Siva130603/Bluetooth-Based-Secure-Locker-with-Access-Logging/IMG-20260924-WA0004.jpg

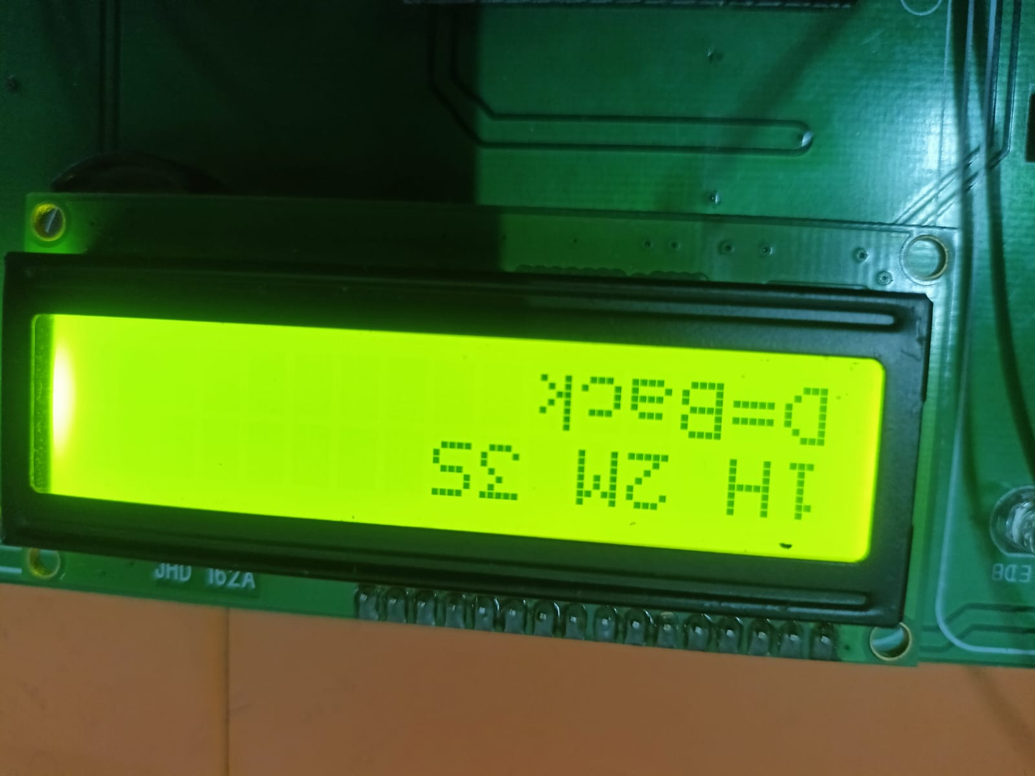
IMG-20260924-WA0004.jpg
