Siva130603/Bluetooth-Based-Secure-Locker-with-Access-Logging/IMG-20260924-WA0006.jpg

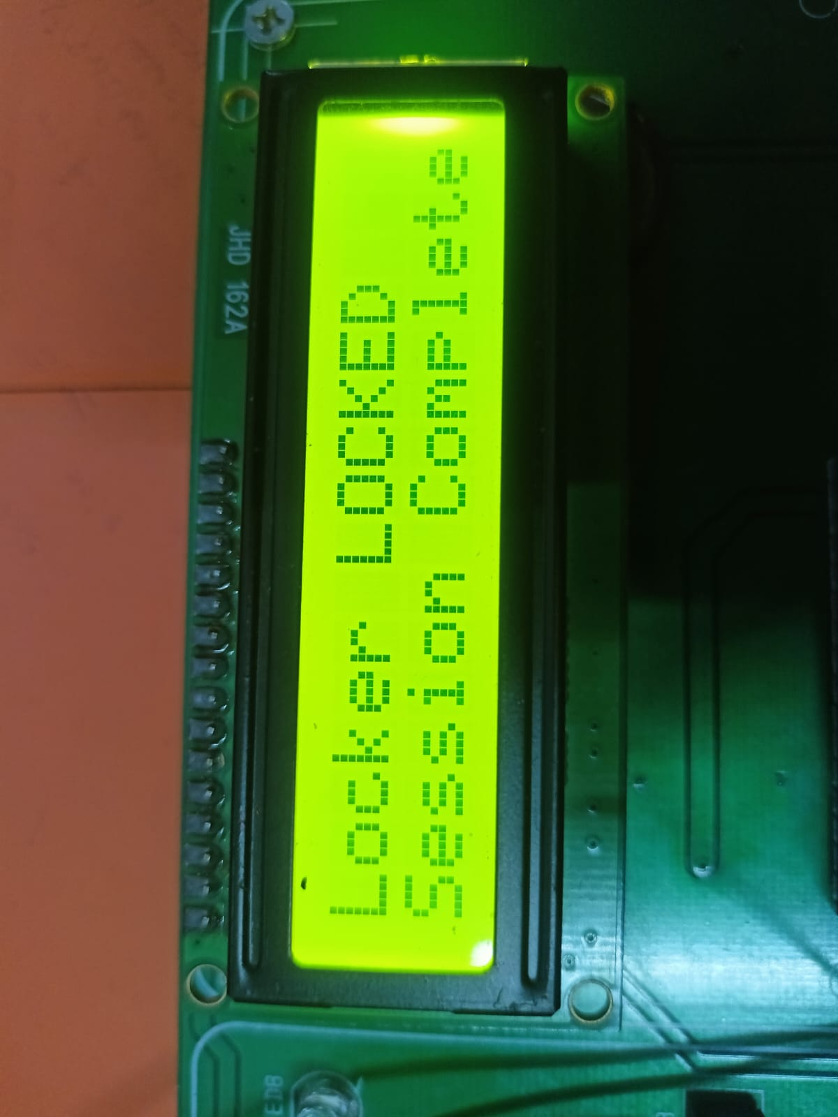
IMG-20260924-WA0006.jpg
