Siva130603/Bluetooth-Based-Secure-Locker-with-Access-Logging/IMG_20260924_191542.jpg

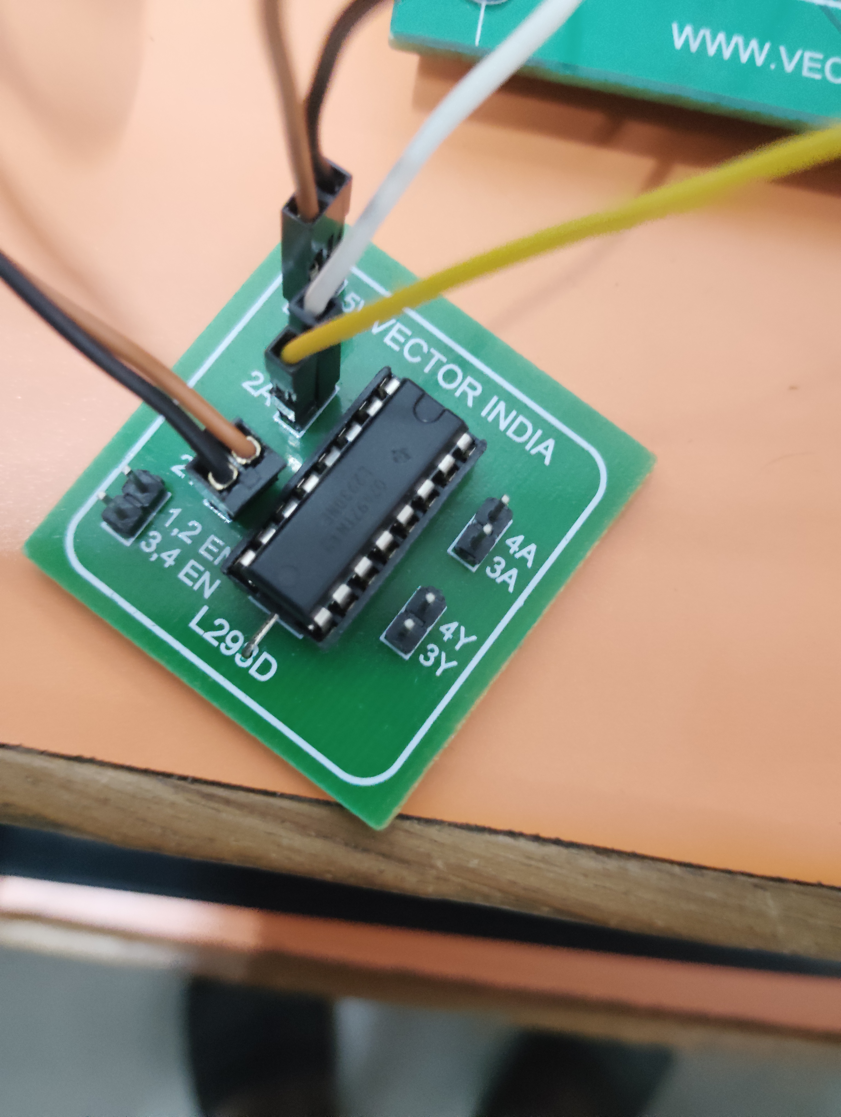
IMG_20260924_191542.jpg
